ignotus666/Bluetooth-Pedalboard/Bluetooth_files/receiver_1.jpg

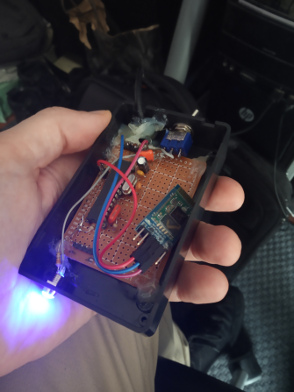
Bluetooth_files/receiver_1.jpg
