ignotus666/Bluetooth-Pedalboard/Bluetooth_files/programming the PIC.odt

Programming the PIC18F2550 without a dedicated PIC programmer:

There is an image of the MIDI-USB circuit included. It has an ICSP header to load the firmware and the tx and rx pins are pins 17 and 18 of the PIC 18F2550, respectively.

Arduino tx would go to rx on the MIDI-USB board. It also requires an additional 22k - 47k resistor from pin 26 (PIC 18F2550) to ground, otherwise it won't work.

Firmware .hex files are included in the repository and will provide 2 MIDI ports, useful if you want to connect the pedalboard to 2 different software applications (Windows often won't allow more than one application to access the same MIDI port).

The .hex file is for a 16MHz clock speed - make sure you use the right oscillator in the circuit. There's also a schematic of the ICSP cable to program the PIC. As shown, two of the header pins aren't used; pin 1 would be the square pad on the MIDI-USB circuit ICSP header.

Using Winpic, set the device to 'PIC18F2550' and the interface type to 'JDM (2) for serial port' in the interface tab, and plug the circuit into the USB port and the COM port with the ICSP cable. Load the .hex file (File → Open).

Click 'Device' -> 'Program (CODE + DATA + CONFIG)'. It will now program the MCU. Sometimes Winpic shows a verification error message but the chip gets programmed anyway, so unplug and plug it in again to check. It should show up as 'MIDI Pedalboard'.

I modified a few things in the firmware but this MIDI-USB circuit and the code originally came from Dmitri Skachkov's Megadrum project, so all credit goes to him.
