ignotus666/Bluetooth-Pedalboard/Bluetooth_files/ICSP_pic18F2550.png

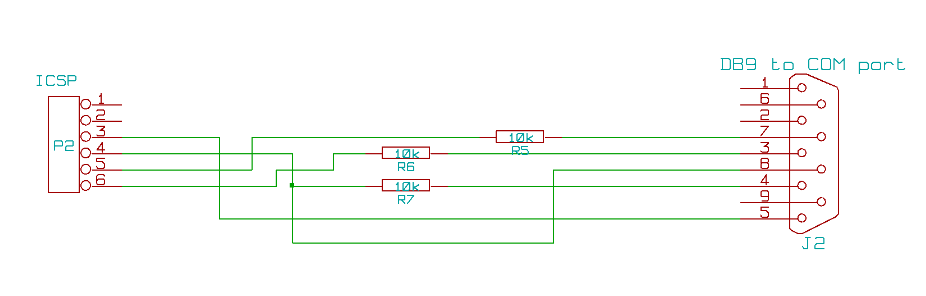
Bluetooth_files/ICSP_pic18F2550.png
