ignotus666/Bluetooth-Pedalboard/Bluetooth_files/USB-MIDI_circuit.png

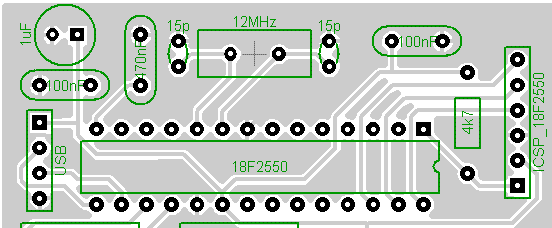
Bluetooth_files/USB-MIDI_circuit.png
