ignotus666/Bluetooth-Pedalboard/Pedalboard_1.01_5_banks/Pedalboard_1.01_5_banks.ino

/******************************************************************************
    Copyright (C) 2020  Daryl Hanlon (ignotus666@hotmail.com)

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
*********************************************************************************/
#include <images.h>
#include <ILI9341_due_config.h>
#include <SystemFont5x7.h>
#include <ILI9341_due.h>
#include <fonts/Arial_bold_14.h>
#include <EEPROM.h>
#include <SPI.h>
#include <MIDI.h>
#include <AnalogSmooth.h>
#include <ResponsiveAnalogRead.h>


// Pin definitions and wiring for TFT:
#define TFT_CS   53
#define TFT_DC   49
#define TFT_RST  48 //Can also be connected to reset on Arduino board.

/*Hardware MOSI and SCK pins for MEGA (can't be freely assigned):
  MOSI -> pin 51
  SCK -> pin 52.
  LED & VCC -> 3.3v
  GND -> GND.
  SCK, MOSI, DC and CS pins must go through 5v -> 3.3v level shifter.
  MISO can be left disconnected if not using SD card.*/

// Create instance of TFT library:
ILI9341_due tft = ILI9341_due(TFT_CS, TFT_DC, TFT_RST);

//LED pin array:
const byte led[9] = {24, 25, 22, 23, 20, 21, 18, 19, 31};
const byte ledCnt = 9;

long unsigned midiLedTime = 0;

//Button arrays and pins:
const byte pressed[10] = {5, 4, 7, 6, 9, 8, 36, 37, 11, 10};
const byte pressCount = 10;

//Expression pedal variables:
byte pedalControlNum = 0;
bool pedalState = 0;
const int pedalPin = A0;
ResponsiveAnalogRead pedal(pedalPin, true, 0.01);
int pedalVal = 0;
int lastPedalVal = 0;   //Initial wah values. One for the first value and another to test if there's been a change.
int pedalRead = 0;
int pedalBar = 0;
char sensorPrintout[4];    //Char array to print wah values.
char oldSensorPrintout[4]; //Char array to print wah values.
int pedalMin = 1023;       // Reference minimum pedal value for calibration.
int pedalMax = 0;          // Maximum pedal value for calibration.
long unsigned calibrateTime = 0;
//eeprom address locations:
#define ADDR_MIN_VAL         0                               //Starts at address zero.
#define ADDR_MAX_VAL         ADDR_MIN_VAL + sizeof(pedalMin) //Use the next free space.
//#define ADDR_X  ADDR_MAX_VAL + sizeof(pedalMax)            //For hypothetical use of more eeprom for something else.

//Digital volume:
int volVal = 64;
int lastVolVal = 0;
int volBar = 0;
int volPerc = 0;

//Battery stuff:
int battPin = 15; //Analog pin to read battery voltage.
AnalogSmooth as = AnalogSmooth(); //Average value of 10 readings.
float battRead = 0;
char voltagePrintout[5];//Char array for battery voltage.
char volPercPrintout[4];//Char array for battery percentage.
int voltageBar = 0;
int voltagePerc = 0;
int lastVoltagePerc = 0;
long unsigned lastReading = -30000;
long unsigned currentReading = 0;
long unsigned battStartupTime = 0;
bool usbOn = true;

//Variables for bank changes:
bool statusBank[5] = {true, false, false, false, false};

int bankNumber = 0;
byte oldBankNumber = 1;

byte bankButtonState = 0;
byte lastBankButton = 0;

byte lastBank = 0; //Variable to enable returning to last bank active before leaving preset mode.
byte b = bankNumber;

const char *smallPresetName[5][6] =
{
  {"MAST. PUP", "B. in BLACK", "STONER", "CLEAN", "CLEANw/EFF", "ECHOEY"}, //Bank 1.
  {"TOOL", "KYUSS", "CYCO", "OCTA", "SANDMAN", "NEUROSIS"},                //Bank 2.
  {"TRIP.DEL", "CRUNCH", "FUZZY", "EXTREME", "SLUDGE", "DOOM"},            //3
  {"PRES.19", "PRES.20", "PRES.21", "PRES.22", "PRES.23", "PRES.24"},      //4
  {"PRES.25", "PRES.26", "PRES.27", "PRES.28", "PRES.29", "PRES.30"}       //5
};                                                                         //For more banks, add more sets (6 per bank) and reflect no. in first parameter after bankNames.

const char *bigPresetName[] =                                                         //Large name printed in centre.
{ "MASTER OF PUPPETS", "BACK IN BLACK", "STONER", "CLEAN", "CLEAN w/EFF", "ECHOEY",   //Bank 1. These differ from the arrays above in that here individual names are printed, not sets.
  "TOOL", "KYUSS", "CYCO", "OCTA", "SANDMAN", "NEUROSIS",                             //Bank 2.
  "TRIPLE DELAY", "CRUNCH", "FUZZY", "EXTREME", "SLUDGE", "DOOM",                     //3
  "PRESET 19", "PRESET 20", "PRESET 21", "PRESET 22", "PRESET 23", "PRESET 24",       //4
  "PRESET 25", "PRESET 26", "PRESET 27", "PRESET 28", "PRESET 29", "PRESET 30"        //5
};                                                                                    //Add more names if adding more banks (6 per bank).

int activeLed = -1;    //Currently active LED. Set at boot to a value not corresponding to any LED.
int lastLed = -1;      //LED to turn off when another one becomes active.
int activePreset = -2; //To return to the last preset active before leaving preset mode. Set to -2 only at boot to stop it printing wrong preset.
int lastActivePreset = 0;
bool presetChanged = false;

//Pedalboard mode variable:
bool stompStatus = false;

//Variables to toggle stomp buttons:
bool stompState[6] = {true, true, true, true, true, true};

long unsigned clearNameTime = 0;

//Variable to toggle loop mode:
bool loopStatus = false;

long unsigned loopTime = 0;

//Variables to toggle loop buttons:
bool loopState[6] = {true, true, true, true, true, true};

//Variables used to control blinking LEDs:
bool ledOn[6] = {false, false, false, false, false, false};
bool ledStatus[6] = {LOW, LOW, LOW, LOW, LOW, LOW};

byte loopLed = 0;

//Variables to hold the times for blinking LEDs:
unsigned long timeNow = 0;
unsigned long timePrev = 0;
unsigned int timeWait = 400;

//Variables to hold the new and old switch states for debouncing:
bool newSwitchState[30] = {LOW, LOW, LOW, LOW, LOW, LOW, LOW, LOW, LOW, LOW,
                           LOW, LOW, LOW, LOW, LOW, LOW, LOW, LOW, LOW, LOW,
                           LOW, LOW, LOW, LOW, LOW, LOW, LOW, LOW, LOW, LOW
                          };

bool oldSwitchState[10] = {LOW, LOW, LOW, LOW, LOW, LOW, LOW, LOW, LOW, LOW};

long unsigned currentDebounceTime = 0;
long unsigned lastDebounceTime = 0;

//Switch states for debouncing:
bool keyPressed[10] = {false, false, false, false, false, false, false, false, false, false};

//Long press variables:
long buttonTimer = 0;
long longPressTime = 700;

boolean button6Active = false;
boolean longPress6Active = false;
boolean button7Active = false;
boolean longPress7Active = false;

//Set up MIDI communication:
MIDI_CREATE_DEFAULT_INSTANCE();

void setup()
{
  for (int p = 0; p < ledCnt; p++)
  {
    pinMode(led[p], OUTPUT);
  }

  for (int b = 0; b < pressCount; b++)
  {
    pinMode(pressed[b], INPUT);
  }

  //Initialise TFT:
  tft.begin();

  tft.setRotation(iliRotation270); //Flip screen upside down because of interfering wires.

  bootSequence();

  MIDI.begin();           //Set up MIDI output.
  //Serial.begin(115200); //For debugging.

  pedalMin = EEPROM.get(ADDR_MIN_VAL, pedalMin); //Load pedal min and max values from eeprom.
  delay(100);
  pedalMax = EEPROM.get(ADDR_MAX_VAL, pedalMax);
  delay(100);
  //Serial.println(pedalMin);
  //Serial.println(pedalMax);
}

void loop()
{
  currentDebounceTime = millis();
  debounceTime();
  wah();

  //Every 10 readings of the analog pin connected to the battery's + terminal, average them:
  float analogSmooth = as.analogReadSmooth(battPin);
  battRead = analogSmooth;

  if (millis() - battStartupTime > 60000 && millis() - battStartupTime < 60100)
  {
    if (battRead < 640) //If it reads less than 3.1v it's on USB power.
    {
      tft.fillRect(1, 223, 35, 16, ILI9341_BLACK);
      tft.setFont(Arial_bold_14);
      tft.setTextColor(ILI9341_CYAN);
      tft.setTextScale(1);
      tft.printAt("USB", 33, 200);
      tft.printAt("POWER", 20, 219);
    }

    else
    {
      tft.drawRoundRect(20, 185, 53, 25, 3, ILI9341_WHITE); //Draw battery
      tft.drawRoundRect(21, 186, 51, 23, 3, ILI9341_WHITE);
      tft.fillRect(73, 193, 4, 8, ILI9341_WHITE);

      tft.setTextColor(ILI9341_CYAN, ILI9341_BLACK);
      tft.setTextScale(1);
      tft.printAt("Batt:", 1, 223);
      
      usbOn = false;
    }
  }

  //Print averaged battery voltage every 30 seconds:
  currentReading = millis();
  readBattery();

  tft.setFont(Arial_bold_14);

  //See which mode is active for bank buttons 7 & 8). Press wah and button 7 to cycle through controller bank change mode (no MIDI), and bank & preset up/down in software (MIDI sent):
  bankMode();

  //What happens when cycling through preset banks (not software banks):
  presetBanks();

  //Determine which bank is active:
  presetBankStatus();

  //Check if pedalboard mode has been activated:
  if (keyPressed[8])
  {
    stompActive();
    keyPressed[8] = false;
  }

  //Check if loop mode has been activated:
  if (keyPressed[9])
  {
    loopActive();
    keyPressed[9] = false;
  }

  //Turn MIDI LED off if it's on:
  midiLedOff();

  if (loopStatus == false)
  {
    lastLed = activeLed;
  }
}

//END OF LOOP().


//CLEAR SPACES:
void clearSmallPresets()   //Clear small preset names but leave large one.
{
  tft.fillRect(1, 1, 320, 16, ILI9341_BLACK);
  tft.fillRect(1, 90, 320, 16, ILI9341_BLACK);
}

void clearTopHalf()
{
  tft.fillRect(0, 1, 320, 152, ILI9341_BLACK);
}

void clearLargeName()     //Clear large preset name.
{
  tft.fillRect(1, 40, 320, 40, ILI9341_BLACK);
}

void clearBankSpace()     //Clear bank number space.
{
  tft.fillRect(95, 152, 85, 22, ILI9341_BLACK);
}

void clearMode()          //Clear loop/stomp/preset mode on message.
{
  tft.fillRect(194, 154, 120, 20, ILI9341_BLACK);
}

void clearBankMode()      //Bank up/down buttons' status space.
{
  tft.fillRect(1, 130, 190, 20, ILI9341_BLACK);
}

void clearPedalName()
{
  tft.fillRect(230, 222, 40, 18, ILI9341_BLACK);
}
