ignotus666/Bluetooth-Pedalboard/Pedalboard_1.01_5_banks/images.h

#if defined(ARDUINO_ARCH_AVR)
    #include <avr/pgmspace.h>
#elif defined(ARDUINO_SAM_DUE)
    #define PROGMEM
#endif

//Guitar facing right:
const uint16_t guitarWidth = 55;
const uint16_t guitarHeight = 68;
const uint16_t guitar[3740] PROGMEM={
0x0000,0x0000,0x0000,0x0000,0x0000,0x0000,0x0000,0x0000,0x0000,0x0000,0x0000,0x0000,0x0000,0x0000,0x0000,0x0000,0x0000,0x0000,0x0000,0x0000,0x0000,0x0000,0x0000,0x0000,0x0000,0x0000,0x0000,0x0000,0x0000,0x0000,0x0000,0x0000,0x0000,0x0000,0x0000,0x0000,0x0000,0x0000,0x0000,0x0841,0x10A2,0x0020,0x0020,0x0841,0x1082,0x18E3,0xAD55,0x2124,0x4A69,0x3186,0xD69A,0x73AE,0x630C,0x1082,0x0861, // row 0, 55 pixels
0x0000,0x0000,0x0000,0x0000,0x0000,0x0000,0x0000,0x0000,0x0000,0x0000,0x0000,0x0000,0x0000,0x0000,0x0000,0x0000,0x0000,0x0000,0x0000,0x0000,0x0000,0x0000,0x0000,0x0000,0x0000,0x0000,0x0000,0x0000,0x0000,0x0000,0x0000,0x0000,0x0000,0x0000,0x0000,0x0000,0x0000,0x0000,0x0000,0x0020,0x0000,0x2945,0x2124,0x0861,0x18E3,0x73AE,0x2104,0x2124,0x632C,0x73AE,0x2965,0x2965,0x2945,0x0000,0x0841, // row 1, 110 pixels
0x0000,0x0000,0x0000,0x0000,0x0000,0x0000,0x0000,0x0000,0x0000,0x0000,0x0000,0x0000,0x0000,0x0000,0x0000,0x0000,0x0000,0x0000,0x0000,0x0000,0x0000,0x0000,0x0000,0x0000,0x0000,0x0000,0x0000,0x0000,0x0000,0x0000,0x0000,0x0000,0x0000,0x0000,0x0000,0x0000,0x0000,0x0000,0x0000,0x0861,0x10A2,0x0000,0x31A6,0x630C,0x18E3,0x31A6,0x8430,0x52AA,0x738E,0x0861,0x632C,0x4A49,0x0000,0x0000,0x0861, // row 2, 165 pixels
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
0x0882,0x0841,0x2081,0x5905,0x91A8,0xB20A,0xCA4B,0xDA6D,0xEAAE,0xF2CE,0xF2EE,0xEAEE,0xEACE,0xE2CE,0xDAAD,0xCA6C,0xC24C,0xC24C,0xC24C,0xC24C,0xC24C,0xC24C,0xCA6C,0xD28D,0xDAAD,0xE2AE,0xEACE,0xEACE,0xF2AE,0xEA8D,0xDA4C,0xCA2A,0xB1C9,0x8987,0x60E4,0x2062,0x0041,0x0861, // row 67, 2584 pixels
0x10A3,0x10A2,0x10A2,0x18A2,0x28C3,0x38C3,0x48E4,0x6105,0x7946,0x8987,0xA1C9,0xB1E9,0xBA0A,0xCA2B,0xD24B,0xD24C,0xDA6C,0xDA6C,0xE26C,0xE26C,0xDA6C,0xDA6C,0xD24B,0xCA2B,0xCA0A,0xB9EA,0xB1C9,0xA1A8,0x8987,0x7946,0x6105,0x48E4,0x38E3,0x28C3,0x18A2,0x10A2,0x10C2,0x10C3, // row 68, 2622 pixels
0x10C3,0x18C3,0x18C3,0x10C3,0x10C3,0x10A3,0x10A3,0x18C3,0x18C3,0x20A3,0x30A3,0x38A3,0x40C4,0x48C4,0x50E4,0x5904,0x6105,0x6125,0x6125,0x6925,0x6125,0x6105,0x5904,0x50E4,0x48C4,0x40C3,0x38C3,0x28C3,0x20C3,0x18A3,0x18A3,0x18A3,0x10C3,0x10C3,0x10E3,0x10E3,0x18E3,0x18E3}; // row 69, 2660 pixels
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
